Soupcan09/Firebird-Gauges-Multi/Old/Firebird_Gauge_Ladder_Diagram_Rev2.pdf

# FIREBIRD WATER TEMP GAUGE

## Power & Signal Wiring -- Ladder Diagram

1967 Pontiac Firebird | ESP32-S3 + ADS1115 + Prosport PSOWTS-JPN | Rev 2.1 (wiring print)

## ◆ +12V POWER INPUT PROTECTION

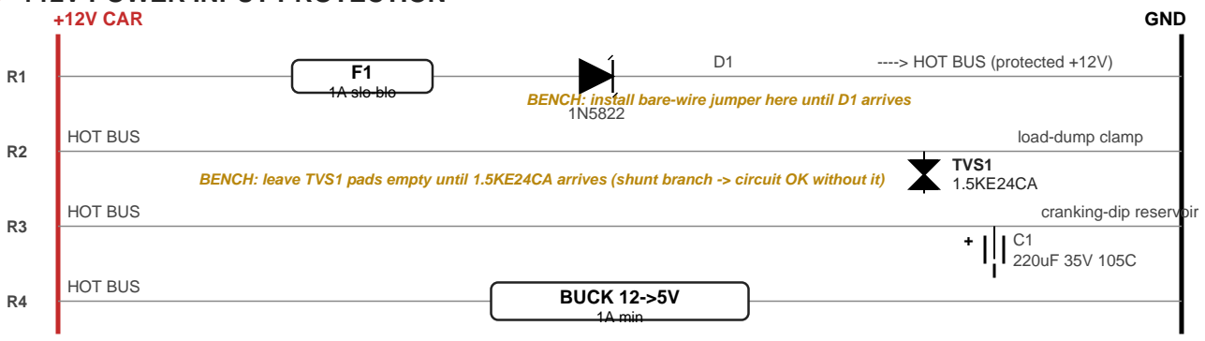
[picture p3: figure]
+12V CAR; GND; 1A slo-blo; ----> HOT BUS (protected +12V); HOT BUS; TVS1 1.5KE24CA; load-dump clamp; cranking-dip reservoir; HOT BUS BUCK 12->5V; 1A min

BENCH: install bare-wire jumper here until D1 arrives

BENCH: leave TVS1 pads empty until 1.5KE24CA arrives (shunt branch -> circuit OK without it)

## ◆ +5V -> WAVESHARE

+5V | GND
R5 | WAVESHARE ESP32-S3 USB-C VBUS / onboard 3.3V reg / I2C port

## ◆ SENSOR INPUT PROTECTION (3.3V from Waveshare I2C port)

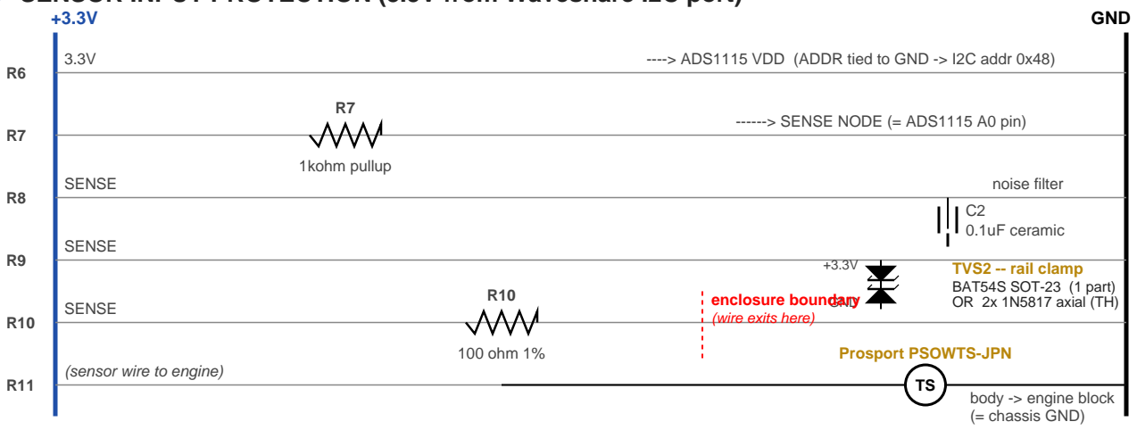
[picture p4: figure]
GND; 1kohm pullup; ------> SENSE NODE (= ADS1115 A0 pin); SENSE; C2 0.1uF ceramic; noise filter; TVS2 -- rail clamp BAT54S SOT-23 (1 part) OR 2x 1N5817 axial (TH); 100 ohm 1%; enclosure boundary (wire exits here); (sensor wire to engine); Prosport PSOWTS-JPN; body -> engine block (= chassis GND)

3.3V | ----> ADS1115 VDD (ADDR tied to GND -> I2C addr 0x48)

## ◆ I2C BUS (4-pin JST on back of Waveshare board)

R12

SDA <--> ADS1115 SDA SCL <--> ADS1115 SCL

### BILL OF MATERIALS

F1 | Fuse 1A slow-blow ATO + inline holder | D1 | 1N5822 Schottky, 40V / 3A axial
TVS1 | 1.5KE24CA bidirectional (load-dump clamp) | C1 | 220uF 35V 105C electrolytic, radial
TVS2 | BAT54S SOT-23 OR 2x 1N5817 axial | C2 | 0.1uF 50V ceramic disc
R7 | 1kohm 1% 1/4W metal-film (pullup) | R10 | 100 ohm 1% 1/4W metal-film (current-limit)
BUCK | 12V -> 5V buck module (LM2596 / MP1584) | TS | Prosport PSOWTS-JPN coolant temp sender
Rev 2 (gold): TVS2 changed from P6KE6.8A to BAT54S/1N5817 -- P6KE clamps too high (~10.5V) for ADS1115 (3.6V abs max).
Rev 2.1: sender corrected to Prosport PSOWTS-JPN; gold BENCH notes show what to do until D1 / TVS1 arrive.
1N5817 substitute wiring (R9): D-up = anode->SENSE / cathode->+3.3V; D-down = anode->GND / cathode->SENSE. Banded end = cathode.

STAR-GROUND: all GND connections meet at one point on the protoboard. Keep the long sensor wire shielded where possible. Route away from ignition coils.
