Soupcan09/Firebird-Gauges-Multi/pontiac_speed_face_final.png

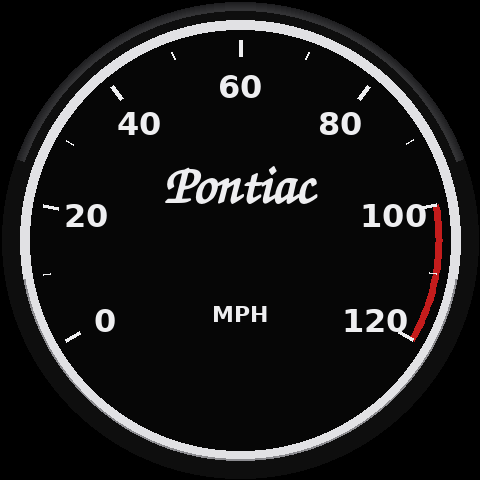
pontiac_speed_face_final.png
