Soupcan09/Firebird-Gauges-Multi/mount/firebird_gauge_podR1.3mf

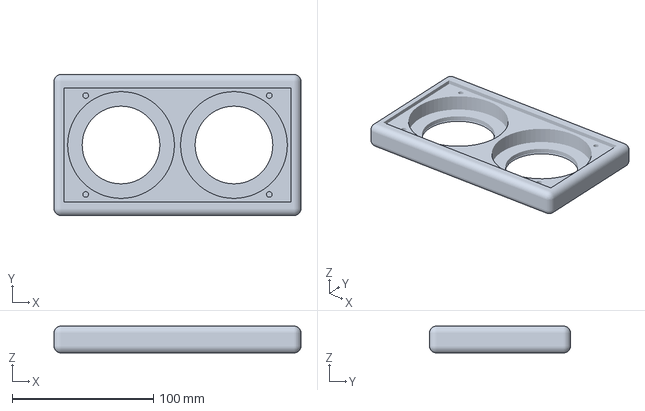
[picture p7: CAD file, 2026-05-31]
mount/firebird_gauge_podR1.3mf
175.0 x 100.0 x 19.0 mm
