Soupcan09/Firebird-Gauges-Multi/mount/Unnamed3.FCStd

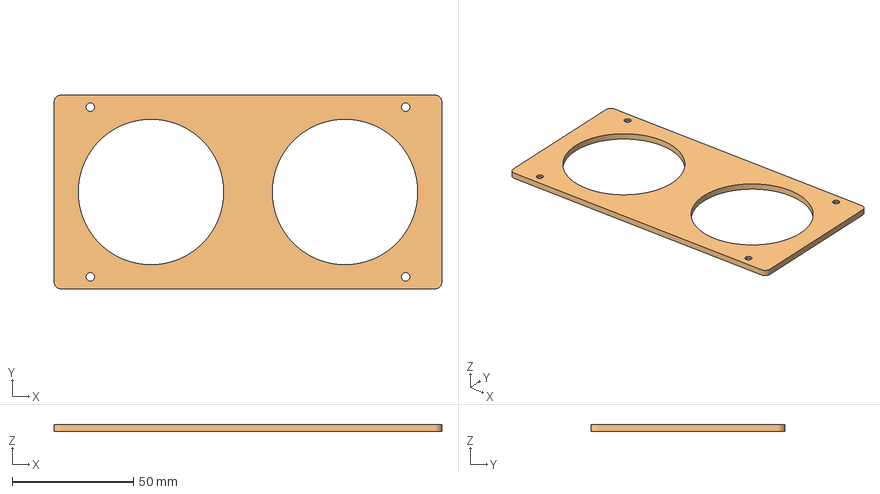
[picture p8: CAD file, 2026-05-31]
mount/Unnamed3.FCStd
160.0 x 80.0 x 3.00 mm
firebird_pod_back_cover002
firebird_pod_back_cover002 (Solid)
firebird_pod_back_cover
