Soupcan09/Firebird-Gauges-Multi/mount/FireBird 2 Lcd Ws display Cover R2.stl

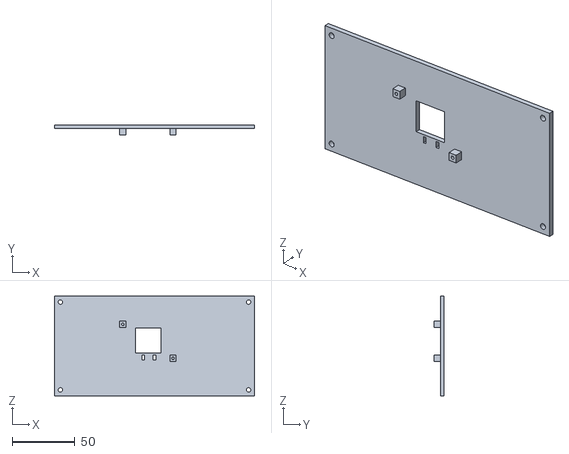
[picture p9: CAD file, 2026-05-31]
mount/FireBird 2 Lcd Ws display Cover R2.stl
159.5 x 8.00 x 79.5
