Soupcan09/Firebird-Gauges-Multi/mount/Firebird 2 lcd Waveshare display.3mf

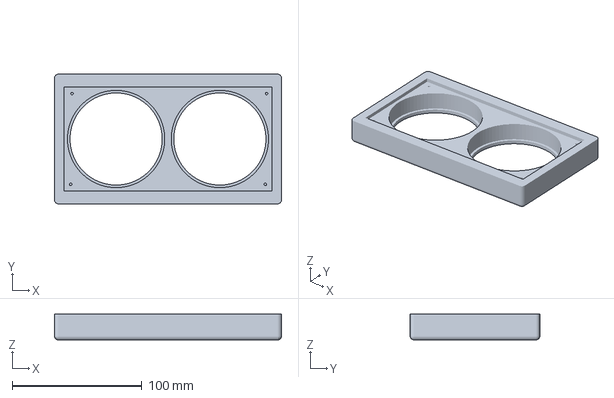
[picture p10: CAD file, 2026-05-31]
mount/Firebird 2 lcd Waveshare display.3mf
175.0 x 100.0 x 20.0 mm
