Soupcan09/Firebird-Gauges-Multi/mount/Unnamed.FCStd

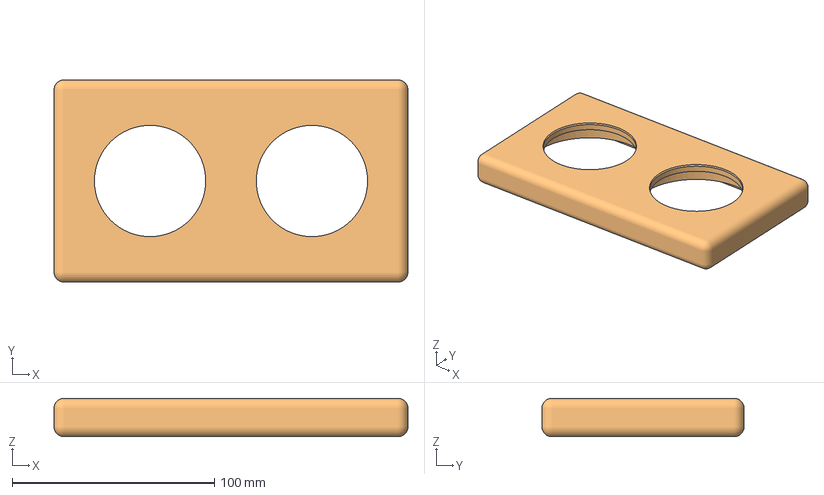
[picture p11: CAD file, 2026-05-31]
mount/Unnamed.FCStd
175.0 x 100.0 x 19.0 mm
firebird_gauge_podR002 (Solid)
firebird_gauge_podR1
