Soupcan09/Firebird-Gauges-Multi/mount/FireBird 2 Lcd Ws display R2.3mf

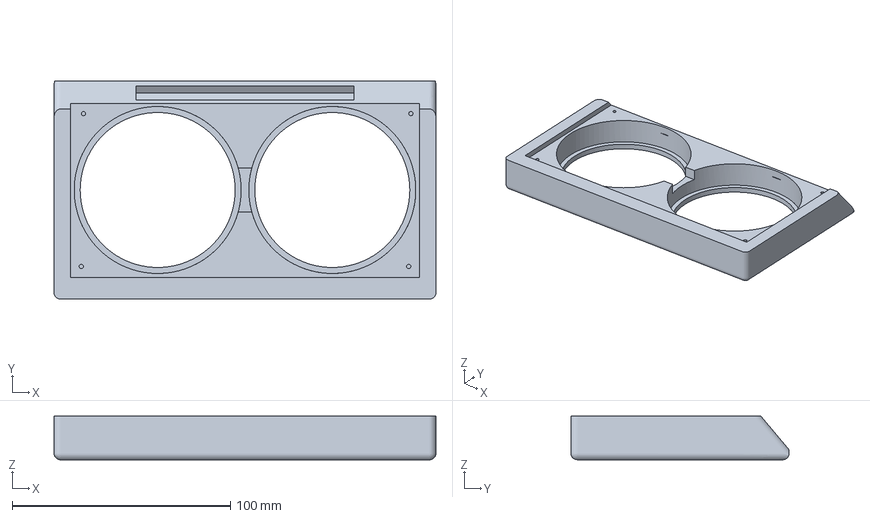
[picture p12: CAD file, 2026-05-31]
mount/FireBird 2 Lcd Ws display R2.3mf
175.0 x 100.0 x 20.0 mm
