Soupcan09/Firebird-Gauges-Multi/mount/firebird_pod_back_cover.step

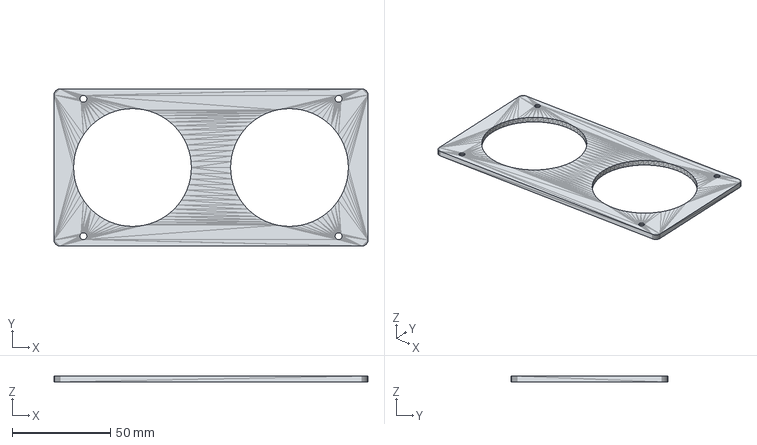
[picture p13: CAD file, 2026-05-31]
mount/firebird_pod_back_cover.step
160.0 x 80.0 x 3.00 mm
