Soupcan09/Firebird-Gauges-Multi/(list of files, cad)

Other CAD files:
mount/firebird_gauge_podR1.scad
mount/FireBird 2 Lcd Ws display R2.stl
mount/Firebird 2 lcd Waveshare display.stl
mount/firebird_gauge_podR1.stl
mount/firebird_pod_back_cover.stl
