Soupcan09/Firebird-Gauges-Multi/main/main.c

#include <stdio.h>
#include "sdkconfig.h"
#include "freertos/FreeRTOS.h"
#include "freertos/task.h"
#include "freertos/semphr.h"
#include "TCA9554PWR.h"
#include "PCF85063.h"
#include "QMI8658.h"
#include "ST7701S.h"
#include "CST820.h"
#include "SD_MMC.h"
#include "LVGL_Driver.h"
#include "LVGL_Example.h"
#include "display_gauge.h"
#include "splash_screen.h"
#include "Temp_Sender.h"
#include "Settings.h"
#include "Wireless.h"
#include "GPS.h"
#include "OTA.h"
#include "esp_log.h"

void Driver_Loop(void *parameter)
{
    while(1)
    {
        QMI8658_Loop();
        RTC_Loop();
        BAT_Get_Volts();
        vTaskDelay(pdMS_TO_TICKS(100));
    }
    vTaskDelete(NULL);
}
void Driver_Init(void)
{
    Flash_Searching();
    BAT_Init();
    I2C_Init();
    PCF85063_Init();
    QMI8658_Init();
    EXIO_Init();                    // Example Initialize EXIO
    xTaskCreatePinnedToCore(
        Driver_Loop, 
        "Other Driver task",
        4096, 
        NULL, 
        3, 
        NULL, 
        0);
}
void app_main(void)
{  
    Wireless_Init();
    Driver_Init();

    LCD_Init();
    Touch_Init();
    SD_Init();
    LVGL_Init();
/********************* Demo *********************/
    // Lvgl_Example1();  // Waveshare demo UI (disabled)
    Settings_Init();      // Load NVS-backed user prefs (trip, offset, bright, buzzer)
    show_splash();        // Boot splash -> auto-transitions to gauge_screen_show_current()
    TempSender_Init();    // ADS1115 + Prosport sender -> drives the temp needle
    GPS_Init();           // BN-880 NMEA receiver on UART0 (JST UART connector)
    OTA_Init();           // OTA rollback self-check; module ready to receive update triggers
    OTA_StartAutoPoll(30000); // every 30s: check server for new firmware, install if newer

    // lv_demo_widgets();
    // lv_demo_keypad_encoder();
    // lv_demo_benchmark();
    // lv_demo_stress();
    // lv_demo_music();

    while (1) {
        // raise the task priority of LVGL and/or reduce the handler period can improve the performance
        vTaskDelay(pdMS_TO_TICKS(10));
        // The task running lv_timer_handler should have lower priority than that running `lv_tick_inc`
        lv_timer_handler();
    }
}
